roket1428/retina-kbd/case/switchplate.dxf

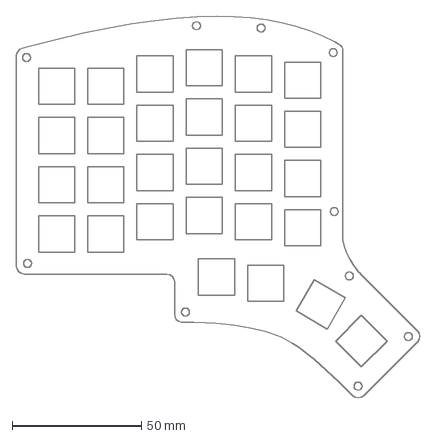
[picture p1: CAD file, 2023-08-20]
case/switchplate.dxf
156.4 x 147.9 mm
