roket1428/retina-kbd/case/backplate.dxf

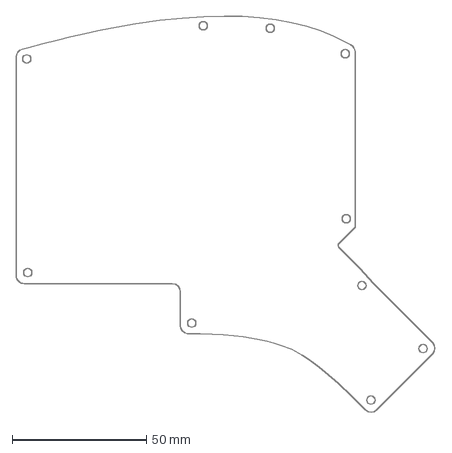
[picture p2: CAD file, 2023-08-20]
case/backplate.dxf
156.4 x 147.9 mm
