roket1428/retina-kbd/retina-left/retina-left.kicad_pcb

## KiCad design retina-left/retina-left.kicad_pcb (2023-08-20)

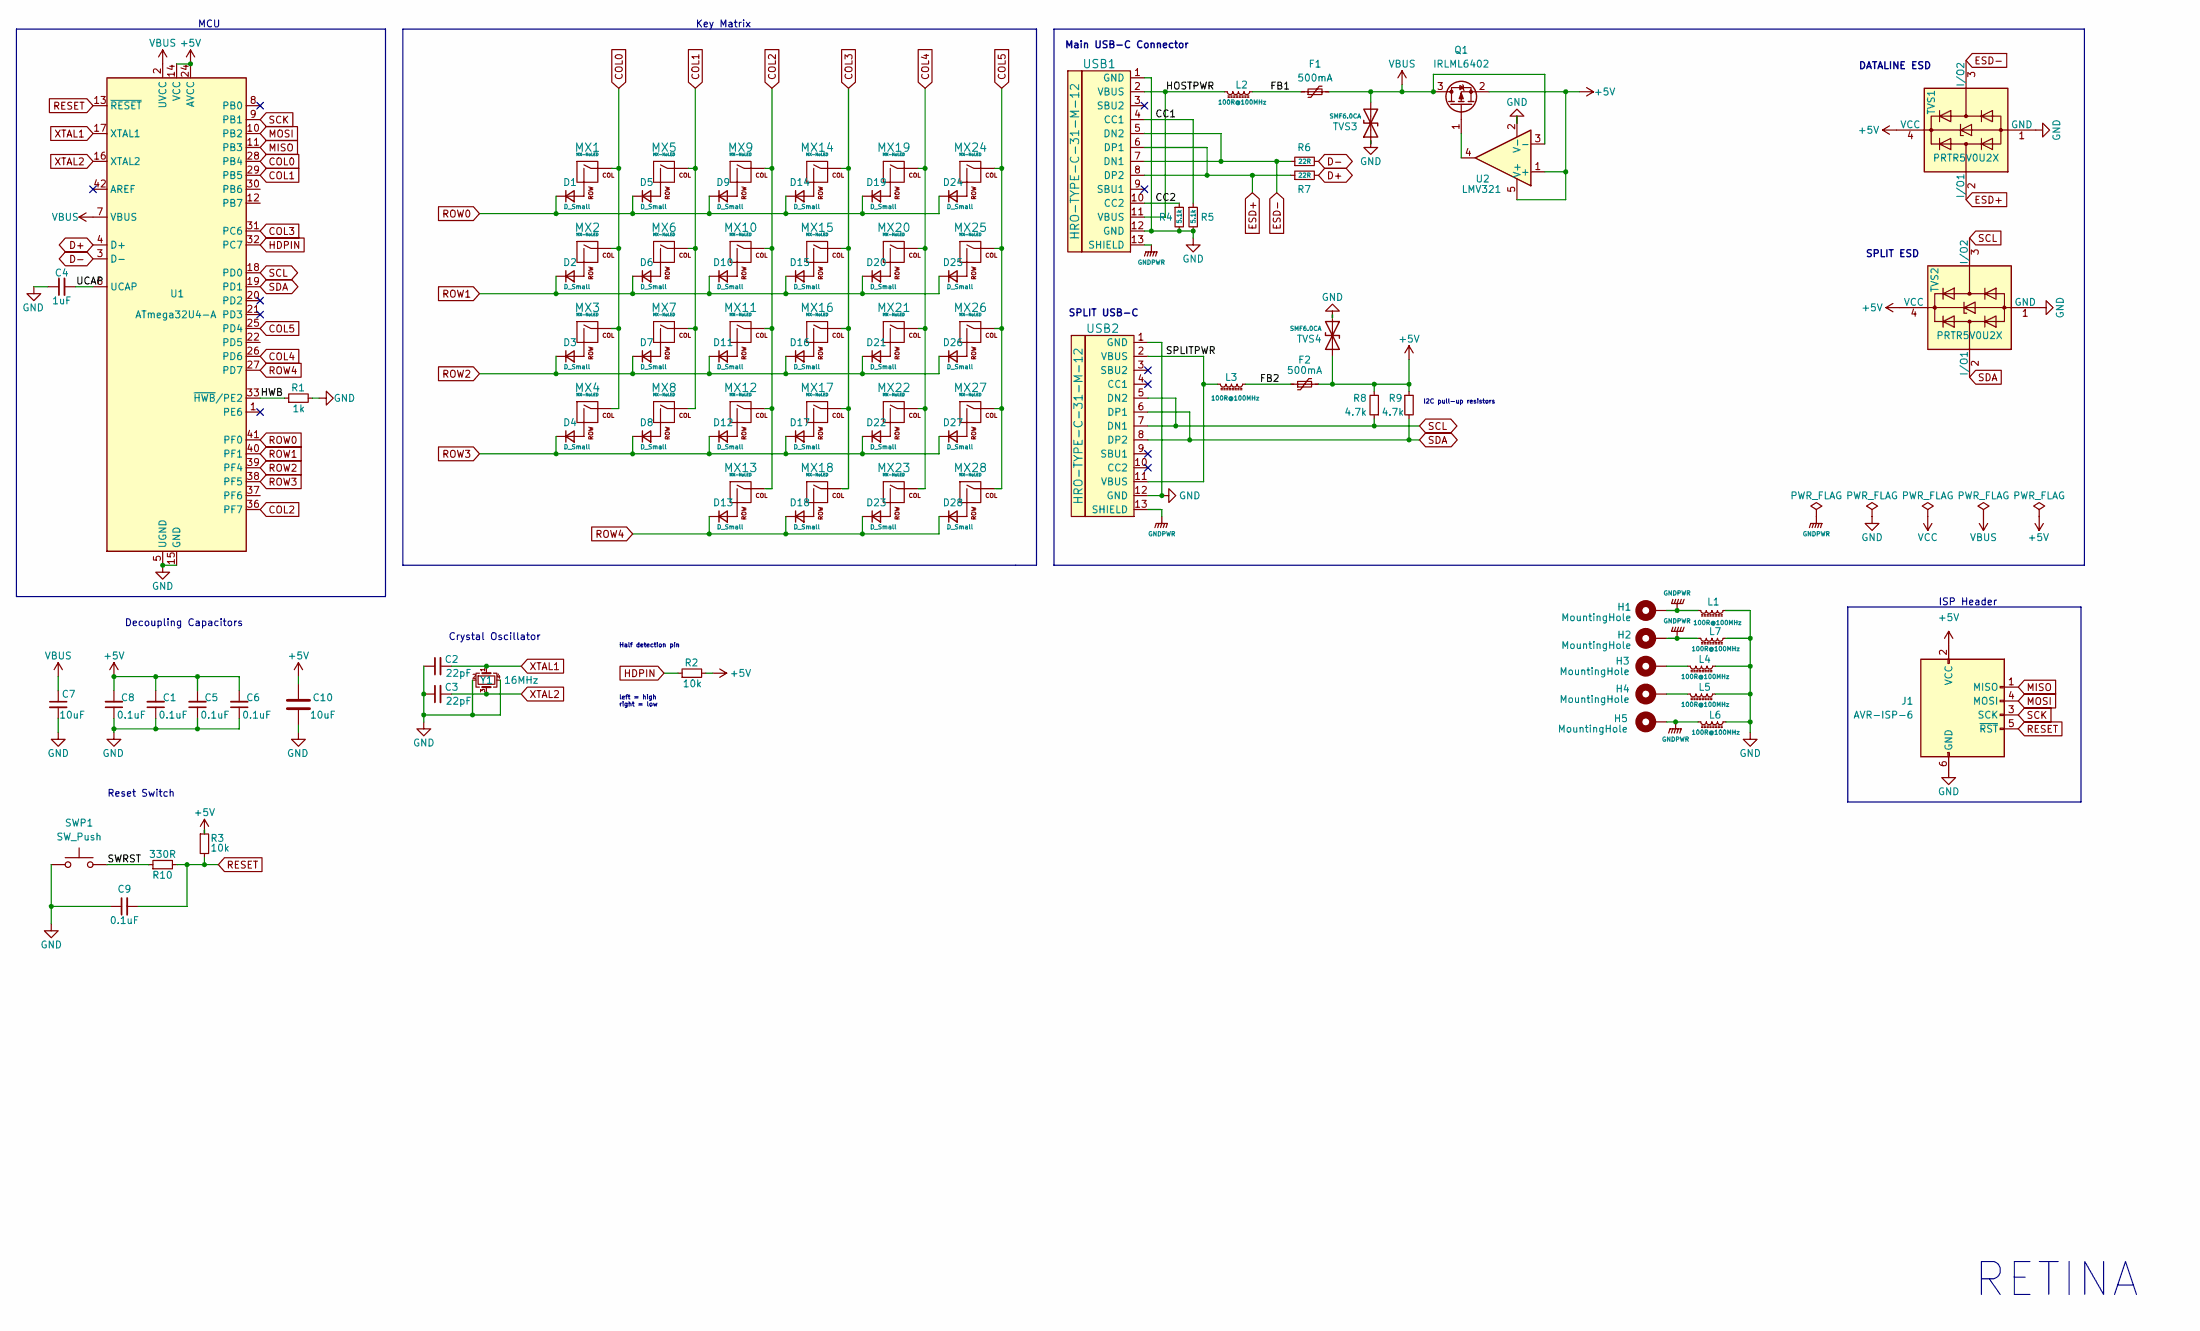
[picture p3: schematic retina-left.kicad_sch, retina]

Parts:
C1, C5, C6, C8, C9: 0.1uF; C_0805_2012Metric_Pad1.18x1.45mm_HandSolder
C2, C3: 22pF; C_0805_2012Metric_Pad1.18x1.45mm_HandSolder
C4: 1uF; C_0805_2012Metric_Pad1.18x1.45mm_HandSolder
C7, C10: 10uF; C_0805_2012Metric_Pad1.18x1.45mm_HandSolder
D1, D2, D3, D4, D5, D6, D7, D8, D9, D10, D11, D12, D13, D14, D15, D16, D17, D18, D19, D20, D21, D22, D23, D24, D25, D26, D27, D28: D_Small; D_DO-35_SOD27_P7.62mm
F1, F2: 500mA; Fuse_1206_3216Metric_Pad1.42x1.75mm_HandSolder
H1, H2, H3, H4, H5: MountingHole; MountingHole_2.2mm_M2_Pad_Via
J1: AVR-ISP-6; Conn_AVR_ISP_6
L1, L2, L3, L4, L5, L6, L7: 100R@100MHz; L_0805_2012Metric_Pad1.05x1.20mm_HandSolder
MX1, MX2, MX3, MX4, MX5, MX6, MX7, MX8, MX9, MX10, MX11, MX12, MX13, MX14, MX15, MX16, MX17, MX18, MX19, MX20, MX21, MX22, MX23, MX24, MX25, MX26, MX27, MX28: MX-NoLED; MXOnly-1U-Hotswap
Q1: IRLML6402; SOT-23_Handsoldering
R1: 1k; R_0805_2012Metric_Pad1.20x1.40mm_HandSolder
R2, R3: 10k; R_0805_2012Metric_Pad1.20x1.40mm_HandSolder
R4, R5: 5.1k; R_0805_2012Metric_Pad1.20x1.40mm_HandSolder
R6, R7: 22R; R_0805_2012Metric_Pad1.20x1.40mm_HandSolder
R8, R9: 4.7k; R_0805_2012Metric_Pad1.20x1.40mm_HandSolder
R10: 330R; R_0805_2012Metric_Pad1.20x1.40mm_HandSolder
SWP1: SW_Push; K2-1187SQ-A4SW-06
TVS1, TVS2: PRTR5V0U2X; SOT-143
TVS3, TVS4: SMF6.0CA; D_SOD-123F
U1: ATmega32U4-A; TQFP-44_10x10mm_P0.8mm
U2: LMV321; SOT-23-5_HandSoldering
USB1, USB2: HRO-TYPE-C-31-M-12; HRO-TYPE-C-31-M-12-HandSoldering
Y1: 16MHz; Crystal_SMD_3225-4Pin_3.2x2.5mm_HandSoldering

Connections:
+5V: C1.2, C5.2, C6.2, C8.2, C10.2, F2.2, J1.2 (VCC), Q1.2 (S), R2.2, R3.1, R8.2, R9.1, TVS1.4 (VCC), TVS2.4 (VCC), TVS4.2 (A2), U1.14 (VCC), U1.24 (AVCC), U1.34 (VCC), U1.44 (AVCC), U2.1 (+), U2.5 (V+)
/CC1: R5.1, USB1.4 (CC1)
/CC2: R4.1, USB1.10 (CC2)
/FB1: F1.1, L2.1
/FB2: F2.1, L3.1
/HOSTPWR: L2.2, USB1.2 (VBUS), USB1.11 (VBUS)
/HWB: R1.1, U1.33 (~HWB/PE2)
/SPLITPWR: L3.2, USB2.2 (VBUS), USB2.11 (VBUS)
/SWRST: R10.1, SWP1.2
/UCAP: C4.2, U1.6 (UCAP)
COL0: MX1.1 (COL), MX2.1 (COL), MX3.1 (COL), MX4.1 (COL), U1.28 (PB4)
COL1: MX5.1 (COL), MX6.1 (COL), MX7.1 (COL), MX8.1 (COL), U1.29 (PB5)
COL2: MX9.1 (COL), MX10.1 (COL), MX11.1 (COL), MX12.1 (COL), MX13.1 (COL), U1.36 (PF7)
COL3: MX14.1 (COL), MX15.1 (COL), MX16.1 (COL), MX17.1 (COL), MX18.1 (COL), U1.31 (PC6)
COL4: MX19.1 (COL), MX20.1 (COL), MX21.1 (COL), MX22.1 (COL), MX23.1 (COL), U1.26 (PD6)
COL5: MX24.1 (COL), MX25.1 (COL), MX26.1 (COL), MX27.1 (COL), MX28.1 (COL), U1.25 (PD4)
D+: R7.2, U1.4 (D+)
D-: R6.2, U1.3 (D-)
ESD+: R7.1, TVS1.2 (I/O1), USB1.6 (DP1), USB1.8 (DP2)
ESD-: R6.1, TVS1.3 (I/O2), USB1.5 (DN2), USB1.7 (DN1)
GND: C1.1, C2.1, C3.1, C4.1, C5.1, C6.1, C7.2, C8.1, C9.1, C10.1, J1.6 (GND), L1.1, L4.1, L5.1, L6.1, L7.1, R1.2, R4.2, R5.2, SWP1.1, TVS1.1 (GND), TVS2.1 (GND), TVS3.1 (A1), TVS4.1 (A1), U1.5 (UGND), U1.15 (GND), U1.23 (GND), U1.35 (GND), U1.43 (GND), U2.2 (V-), USB1.1 (GND), USB1.12 (GND), USB2.1 (GND), USB2.12 (GND), Y1.2, Y1.4
GNDPWR: H1.1, H2.1, H5.1, L1.2, L6.2, L7.2, USB1.13 (SHIELD), USB2.13 (SHIELD)
HDPIN: R2.1, U1.32 (PC7)
MISO: J1.1 (MISO), U1.11 (PB3)
MOSI: J1.4 (MOSI), U1.10 (PB2)
unnamed: D1.2 (A), MX1.2 (ROW)
unnamed: D2.2 (A), MX2.2 (ROW)
unnamed: D3.2 (A), MX3.2 (ROW)
unnamed: D4.2 (A), MX4.2 (ROW)
unnamed: D5.2 (A), MX5.2 (ROW)
unnamed: D6.2 (A), MX6.2 (ROW)
unnamed: D7.2 (A), MX7.2 (ROW)
unnamed: D8.2 (A), MX8.2 (ROW)
unnamed: D9.2 (A), MX9.2 (ROW)
unnamed: D10.2 (A), MX10.2 (ROW)
unnamed: D11.2 (A), MX11.2 (ROW)
unnamed: D12.2 (A), MX12.2 (ROW)
unnamed: D13.2 (A), MX13.2 (ROW)
unnamed: D14.2 (A), MX14.2 (ROW)
unnamed: D15.2 (A), MX15.2 (ROW)
unnamed: D16.2 (A), MX16.2 (ROW)
unnamed: D17.2 (A), MX17.2 (ROW)
unnamed: D18.2 (A), MX18.2 (ROW)
unnamed: D19.2 (A), MX19.2 (ROW)
unnamed: D20.2 (A), MX20.2 (ROW)
unnamed: D21.2 (A), MX21.2 (ROW)
unnamed: D22.2 (A), MX22.2 (ROW)
unnamed: D23.2 (A), MX23.2 (ROW)
unnamed: D24.2 (A), MX24.2 (ROW)
unnamed: D25.2 (A), MX25.2 (ROW)
unnamed: D26.2 (A), MX26.2 (ROW)
unnamed: D27.2 (A), MX27.2 (ROW)
unnamed: D28.2 (A), MX28.2 (ROW)
unnamed: H3.1, L4.2
unnamed: H4.1, L5.2
unnamed: Q1.1 (G), U2.4
RESET: C9.2, J1.5 (~RST), R3.2, R10.2, U1.13 (~RESET)
ROW0: D1.1 (K), D5.1 (K), D9.1 (K), D14.1 (K), D19.1 (K), D24.1 (K), U1.41 (PF0)
ROW1: D2.1 (K), D6.1 (K), D10.1 (K), D15.1 (K), D20.1 (K), D25.1 (K), U1.40 (PF1)
ROW2: D3.1 (K), D7.1 (K), D11.1 (K), D16.1 (K), D21.1 (K), D26.1 (K), U1.39 (PF4)
ROW3: D4.1 (K), D8.1 (K), D12.1 (K), D17.1 (K), D22.1 (K), D27.1 (K), U1.38 (PF5)
ROW4: D13.1 (K), D18.1 (K), D23.1 (K), D28.1 (K), U1.27 (PD7)
SCK: J1.3 (SCK), U1.9 (PB1)
SCL: R8.1, TVS2.3 (I/O2), U1.18 (PD0), USB2.5 (DN2), USB2.7 (DN1)
SDA: R9.2, TVS2.2 (I/O1), U1.19 (PD1), USB2.6 (DP1), USB2.8 (DP2)
VBUS: C7.1, F1.2, Q1.3 (D), TVS3.2 (A2), U1.2 (UVCC), U1.7 (VBUS), U2.3 (-)
XTAL1: C2.2, U1.17 (XTAL1), Y1.1
XTAL2: C3.2, U1.16 (XTAL2), Y1.3

Notes on the sheet:
Reset Switch
MCU
SPLIT ESD
DATALINE ESD
Crystal Oscillator
I2C pull-up resistors
left = high right = low
Half detection pin
Main USB-C Connector
SPLIT USB-C
Decoupling Capacitors
ISP Header
Key Matrix
RETINA

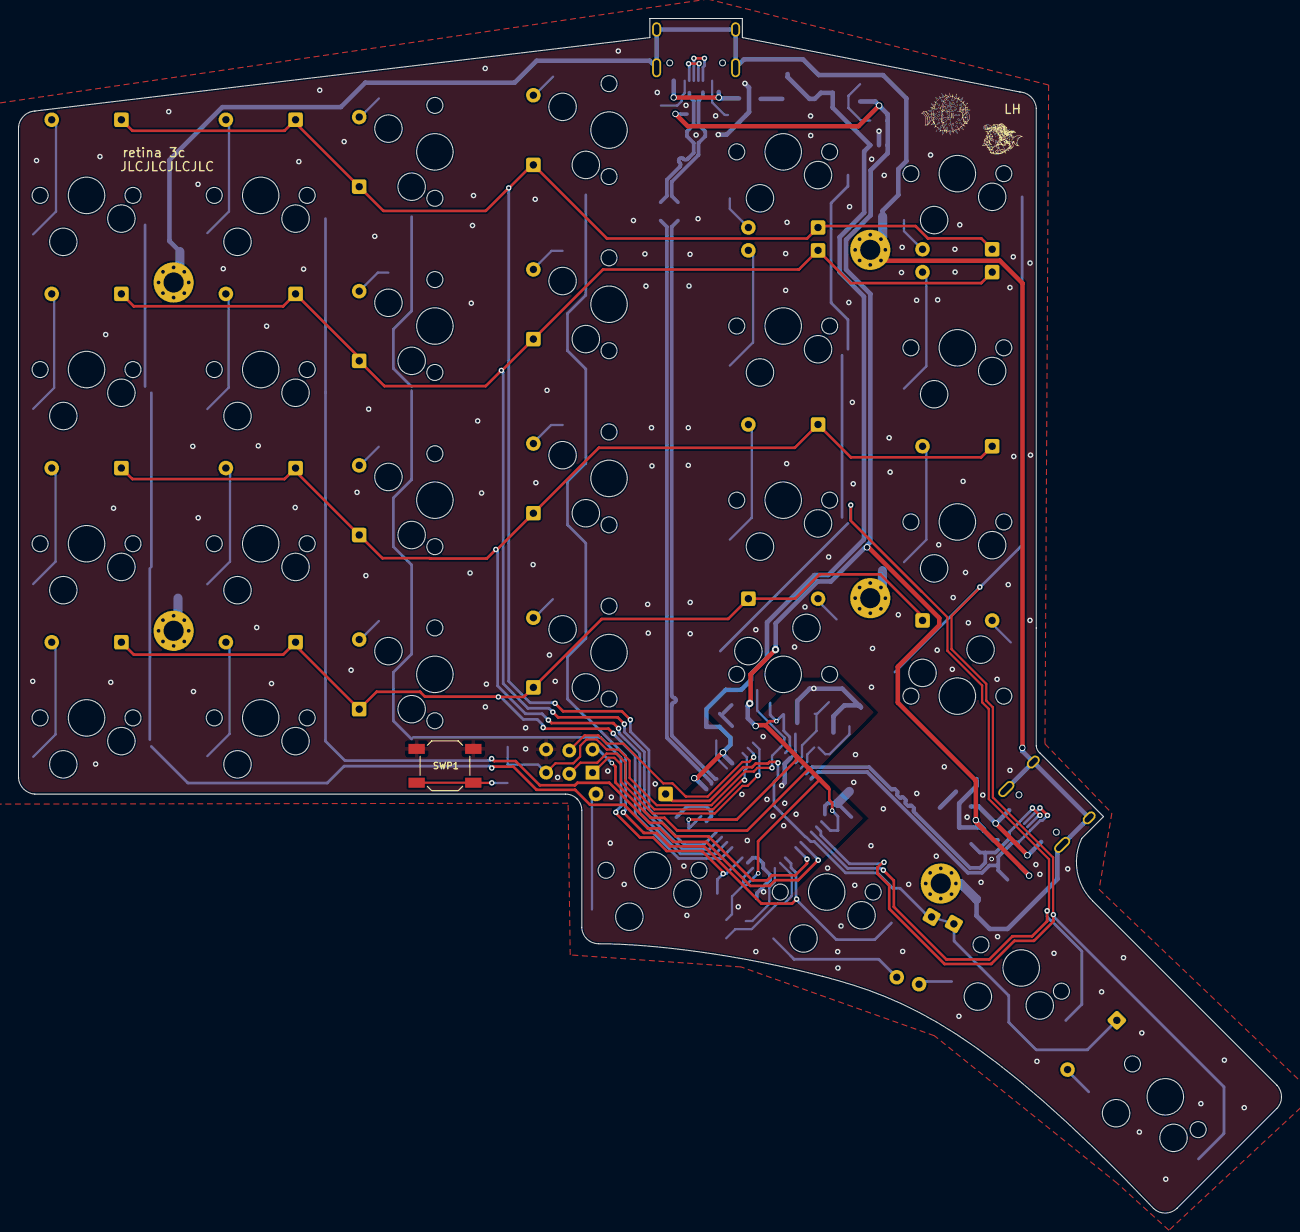
[picture p4: board retina-left.kicad_pcb from above]

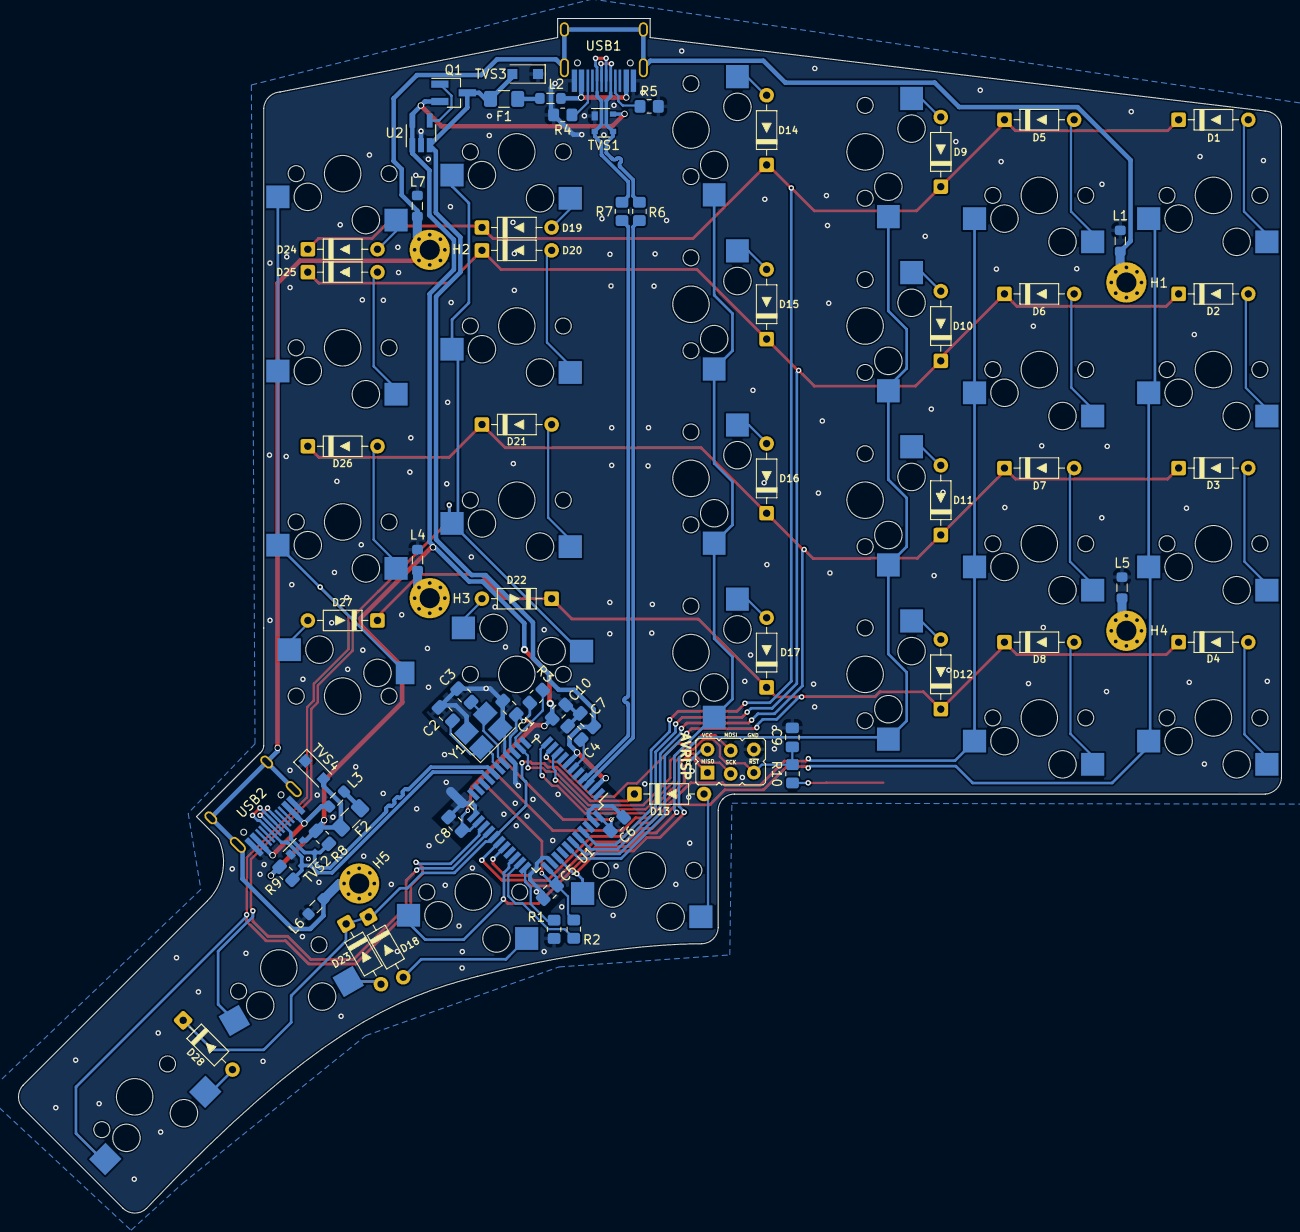
[picture p5: board retina-left.kicad_pcb from below]

Board: 2 copper layers, 138.1 x 130.7 mm, 102 parts (73 on the bottom side), 68 nets.
